andygunn/bakeneko-65/(commit log)

2022-05-25 Updated project with MX-Alps footprints
    Numerous small changes:
    - Updated files to KiCad 6
    - Updated all switch footprints to MX-Alps hybrid footprints
    - Added "3800 style" capslock footprint (Alps only)
    - Added ground fills on both sides of the PCB
    - Some routing fixes and changes due to the MX-Alps footprints
    - Removed the "cutout" for the space in the bottom row between RCTRL and the arrow cluster.
    [bakeneko-65-pcb.kicad_sch, matrix.kicad_sch]
2022-05-26 Dual MCU footprint update
    Ability to use either ATMega32U4 footprint - AU or MU.
    [bakeneko-65-pcb.kicad_sch]
2022-09-02 Small updates - USB routing
    [JST-SR-4.step, bakeneko-65-pcb.kicad_sch]
2022-09-10 Revert "Small updates - USB routing"
    This reverts commit 01b81f097f4a432426e23b6d52fb9b838f85ddba.
    [JST-SR-4.step, bakeneko-65-pcb.kicad_sch]
2022-09-10 Revert "Dual MCU footprint update"
    This reverts commit d3ec1e4d8a5bc08a1e6c0b7459cdd594f23042e6.
    [bakeneko-65-pcb.kicad_sch]
2022-09-10 Revert "Updated project with MX-Alps footprints"
    This reverts commit 01749127192a9d625263cd0dfcbd466de0ce8b34.
    [bakeneko-65-pcb.kicad_sch, matrix.kicad_sch]
2022-09-11 Rework for JST move for Iron165 case
    Changed MCU to ATmega32u4-MU variant, changed switch footprints to MX-Alps hybrid. Trace moves and adjustments as necessary. Path updates for Kicad v6.
    [bakeneko-65-case.step, bakeneko-65-pcb.kicad_sch, bakeneko-65-pcb.sch, bakeneko-65-pla-split-blocker.stl, bakeneko-65-pla-split-left.stl, bakeneko-65-pla-split-right.stl, bakeneko-65-pla-split-usb.stl, bakeneko-65-pla.step]
2022-09-11 USB Trace routing updates
    [bakeneko-65-pcb.kicad_sch]
2022-09-11 Trace updates
    [bakeneko-65-pcb.kicad_sch, matrix.kicad_sch]
2022-09-14 Edge cut update, generate Gerber files
    Updated the edge cuts to be closer to the Iron165 PCB, did some additional trace cleanup, and generated the Gerber, BOM, and positioning files.
    [bakeneko-65-pcb.kicad_sch]
2022-10-02 Small updates to PCB and replot of Gerber
