andygunn/bakeneko-65/(notices)

Notices in the files:
pcb/bakeneko-65-pcb.kicad_sch:
Copyright © 2020 kkatano
MIT License
